mattybrad/omnistomp/enclosure/1590Balt.FCStd

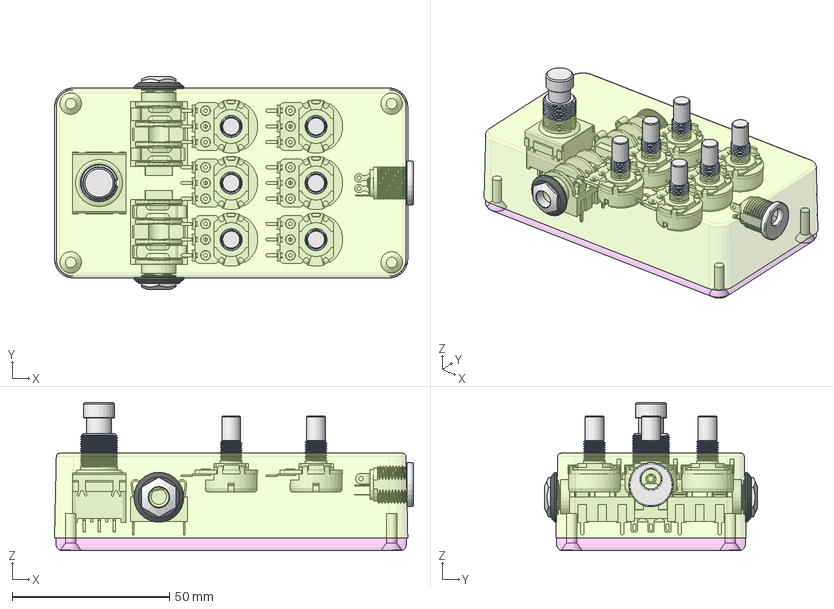
[picture p1: CAD file, 2025-01-20]
enclosure/1590Balt.FCStd
114.2 x 67.9 x 47.2 mm
1590B BOX
1590B-BS LID
SC530 (screw #6-32X 1_2' FH)
SC530 (screw #6-32X 1_2' FH)001
SC530 (screw #6-32X 1_2' FH)002
SC530 (screw #6-32X 1_2' FH)003
DC jack v1
SF17020F-0302-21R-L v2
NMJ4HCD2 v9
NMJ4HCD2 v010
PCB
header
header001
RV16AF-20 v3
RV16AF-20 v004
RV16AF-20 v005
RV16AF-20 v006
RV16AF-20 v007
RV16AF-20 v008
NMJ nut washer v1
NMJ nut v1
NMJ nut washer v002
NMJ nut v002
