mattybrad/omnistomp/enclosure/1590Btopjacks.FCStd

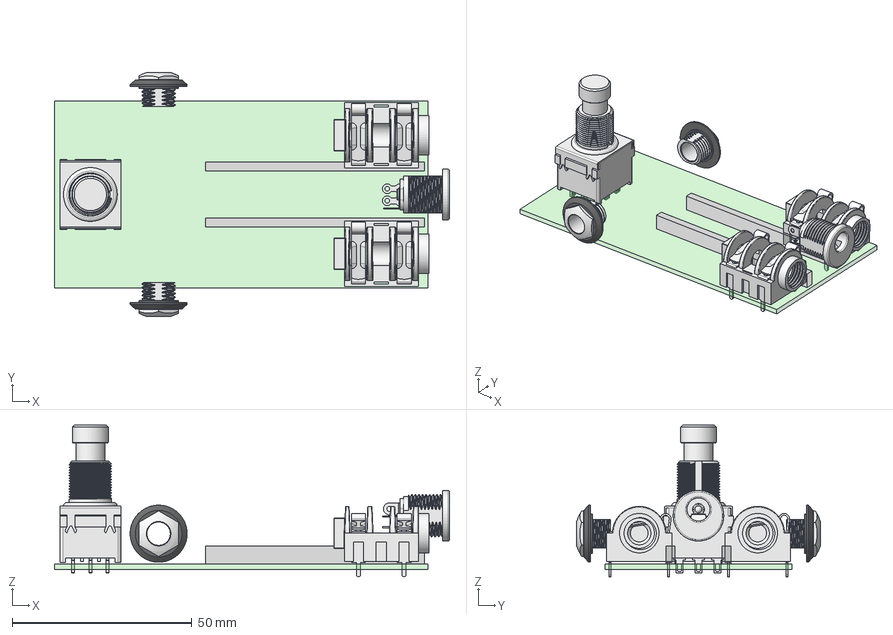
[picture p2: CAD file, 2025-01-20]
enclosure/1590Btopjacks.FCStd
110.0 x 67.9 x 42.2 mm
DC jack v1
SF17020F-0302-21R-L v2
NMJ4HCD2 v9
NMJ4HCD2 v010
PCB
header
header001
NMJ nut washer v1
NMJ nut v1
NMJ nut washer v002
NMJ nut v002
