mattybrad/omnistomp/enclosure/1590B.FCStd

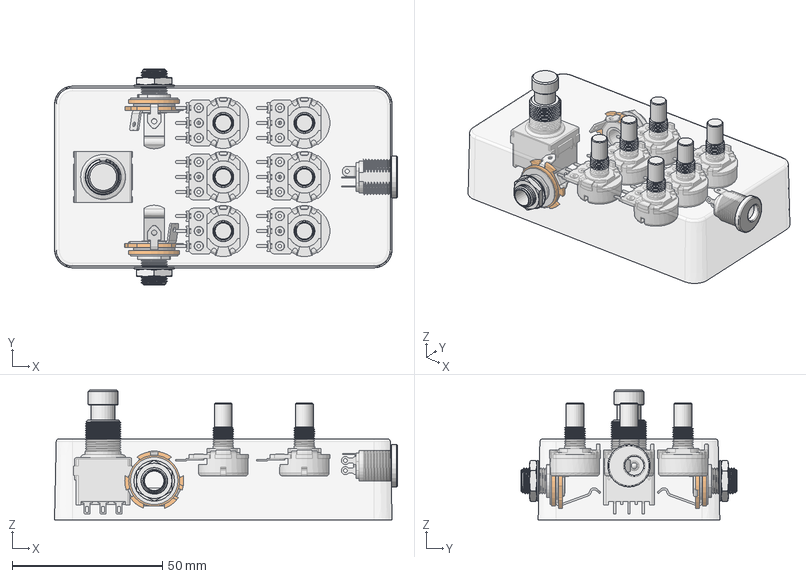
[picture p3: CAD file, 2025-01-17]
enclosure/1590B.FCStd
114.2 x 71.9 x 43.2 mm
1590B BOX
DC jack v1
SF17020F-0302-21R-L v2
PCB
Teensy 4.1
Washer005
Sleeve001
Common_contact001
Washer003
Output_contact001
Washer004
Wacher005
Thread001
Washer006
Washer007
Sleeve002
Common_contact002
Washer009
Output_contact002
Washer008
Wacher006
Thread002
Washer010
header
header001
RV16AF-20 v3
RV16AF-20 v004
RV16AF-20 v005
RV16AF-20 v006
RV16AF-20 v007
RV16AF-20 v008
