mattybrad/omnistomp/pcb/stomp_01/stomp_01.kicad_pcb

## KiCad design pcb/stomp_01/stomp_01.kicad_pcb (2025-05-21)

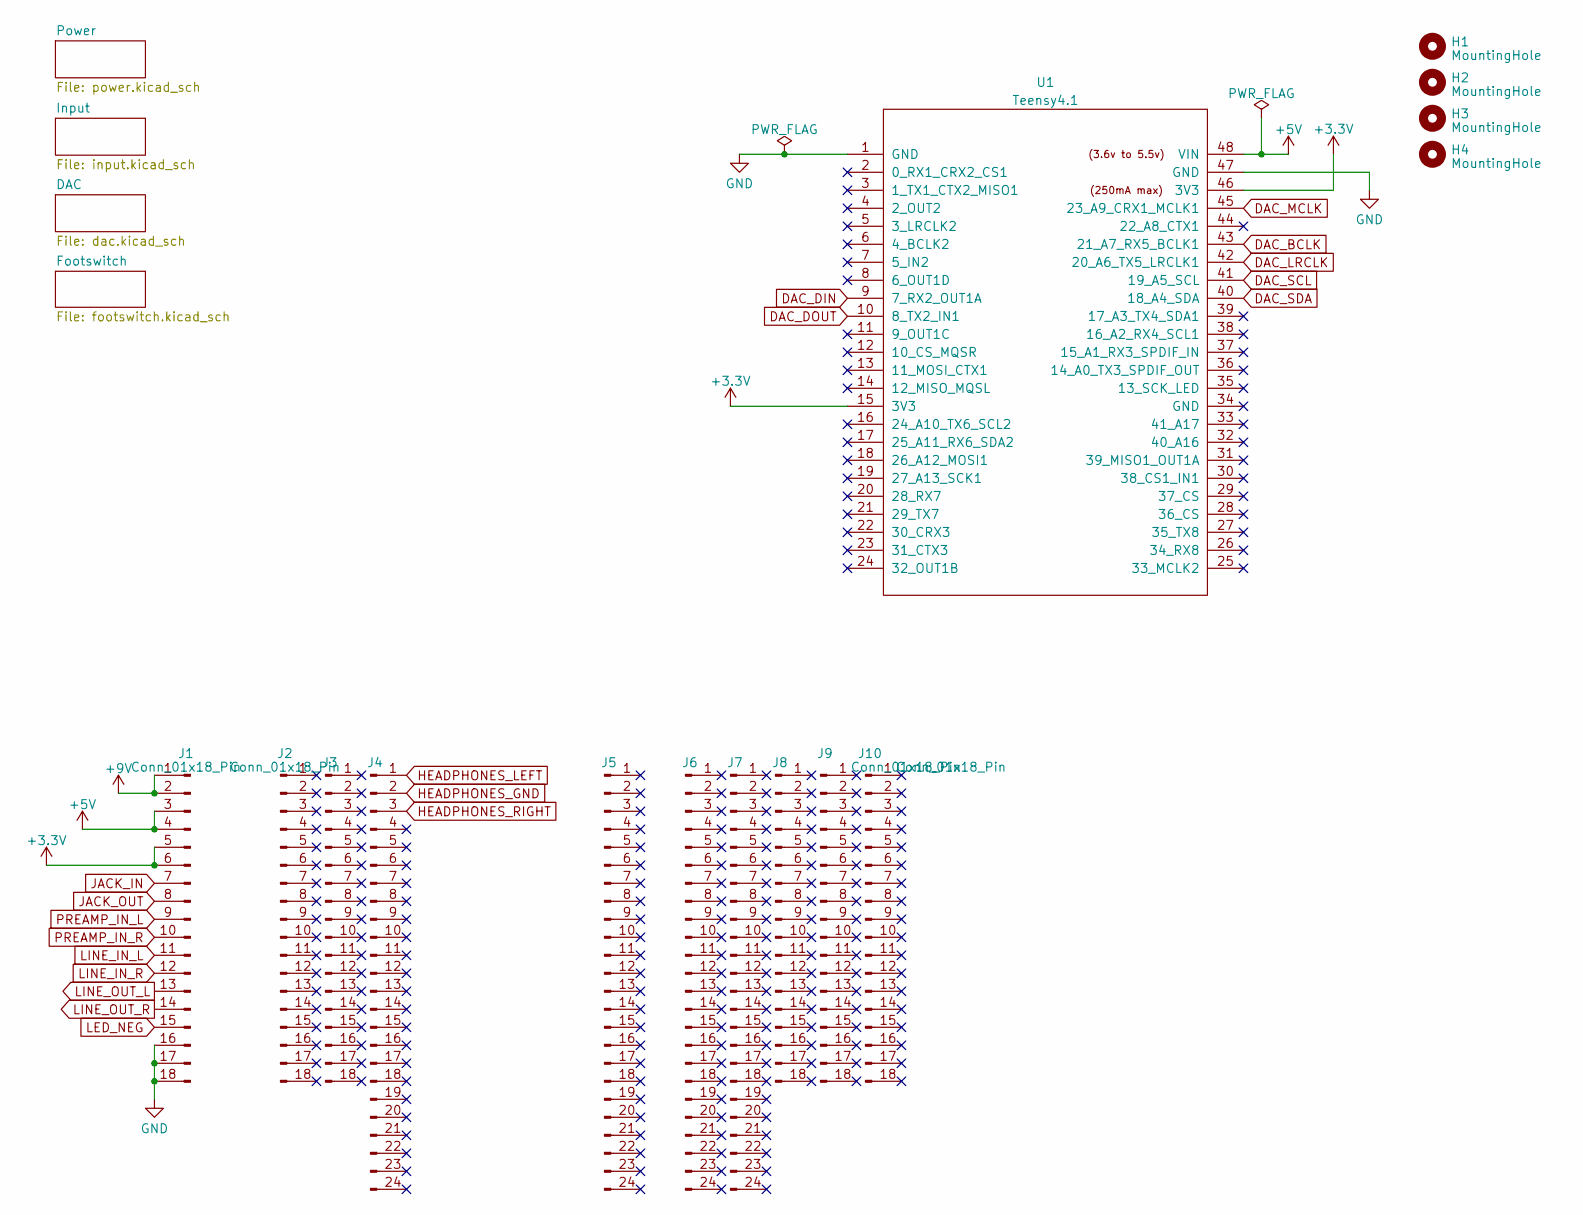
[picture p4: schematic stomp_01.kicad_sch]

Parts:
H1, H2, H3, H4: MountingHole; MountingHole_3.2mm_M3
J1, J2, J3, J8, J9, J10: Conn_01x18_Pin; PinHeader_1x18_P2.54mm_Vertical_perf
J4, J5, J6, J7: Conn_01x18_Pin; PinHeader_1x24_P2.54mm_Vertical_perf
U1: Teensy4.1; Teensy41_stomp

Connections:
+3.3V: J1.5, J1.6, U1.15 (3V3), U1.46 (3V3); also elsewhere on the board
+5V: J1.3, J1.4, U1.48 (VIN); also elsewhere on the board
+9V: J1.1, J1.2; also elsewhere on the board
DAC_BCLK: U1.43 (21_A7_RX5_BCLK1); also elsewhere on the board
DAC_DIN: U1.9 (7_RX2_OUT1A); also elsewhere on the board
DAC_DOUT: U1.10 (8_TX2_IN1); also elsewhere on the board
DAC_LRCLK: U1.42 (20_A6_TX5_LRCLK1); also elsewhere on the board
DAC_MCLK: U1.45 (23_A9_CRX1_MCLK1); also elsewhere on the board
DAC_SCL: U1.41 (19_A5_SCL); also elsewhere on the board
DAC_SDA: U1.40 (18_A4_SDA); also elsewhere on the board
GND: J1.16, J1.17, J1.18, U1.1 (GND), U1.47 (GND); also elsewhere on the board
HEADPHONES_GND: J4.2; also elsewhere on the board
HEADPHONES_LEFT: J4.1; also elsewhere on the board
HEADPHONES_RIGHT: J4.3; also elsewhere on the board
JACK_IN: J1.7; also elsewhere on the board
JACK_OUT: J1.8; also elsewhere on the board
LED_NEG: J1.15; also elsewhere on the board
LINE_IN_L: J1.11; also elsewhere on the board
LINE_IN_R: J1.12; also elsewhere on the board
LINE_OUT_L: J1.13; also elsewhere on the board
LINE_OUT_R: J1.14; also elsewhere on the board
PREAMP_IN_L: J1.9; also elsewhere on the board
PREAMP_IN_R: J1.10; also elsewhere on the board

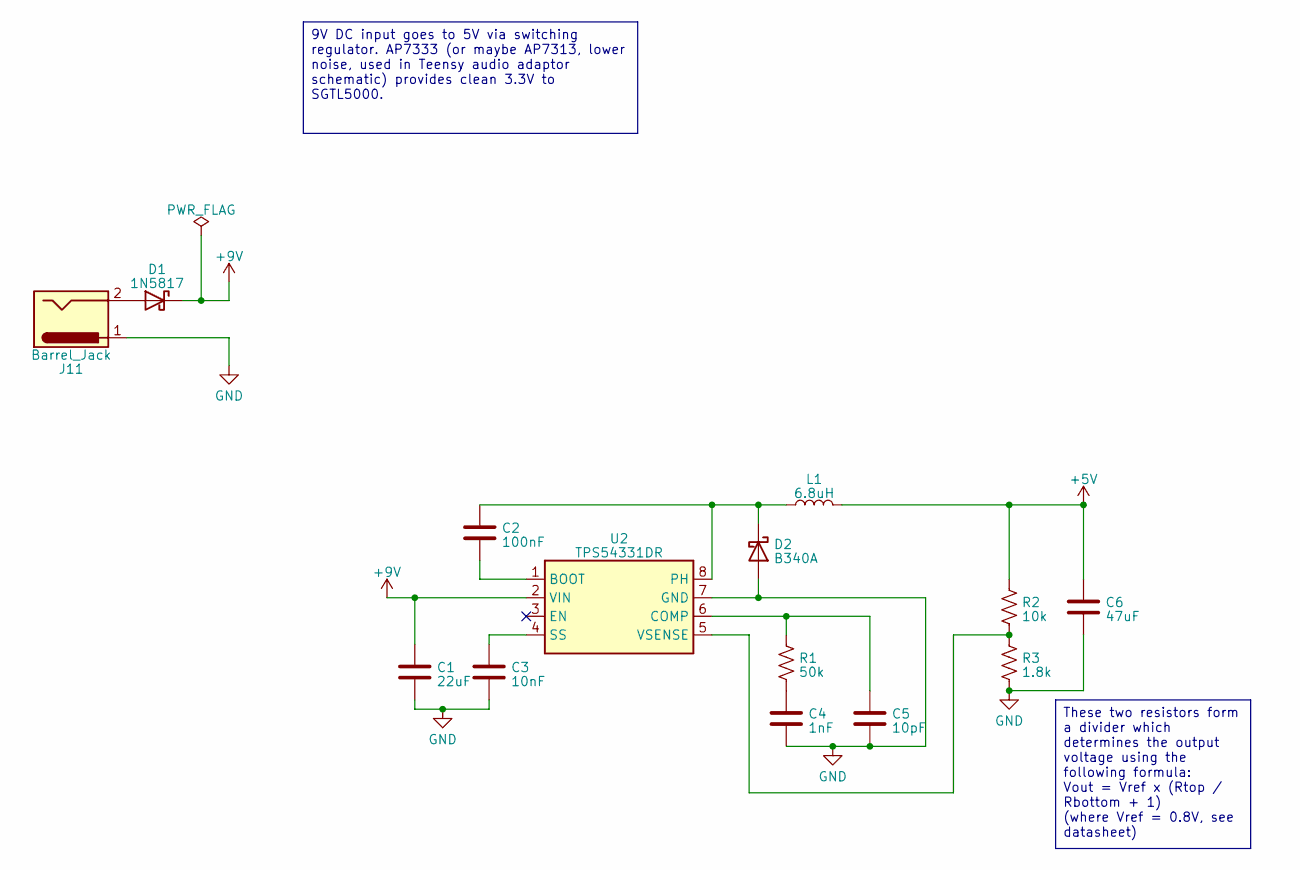
[picture p5: schematic power.kicad_sch]

Parts:
C1: 22uF; C_0805_2012Metric
C2: 100nF; C_0603_1608Metric
C3: 10nF; C_0603_1608Metric
C4: 1nF; C_0603_1608Metric
C5: 10pF; C_0603_1608Metric
C6: 47uF; C_1210_3225Metric
D1: 1N5817; D_DO-41_SOD81_P10.16mm_Horizontal
D2: B340A; D_SMA
J11: Barrel_Jack; SolderWire-1sqmm_1x02_P5.4mm_D1.4mm_OD2.7mm
L1: 6.8uH; L_Sunlord_SWPA6045S
R1: 50k; R_0603_1608Metric
R2: 10k; R_0603_1608Metric
R3: 1.8k; R_0603_1608Metric
U2: TPS54331DR; SOIC-8_3.9x4.9mm_P1.27mm

Connections:
+5V: C6.1, L1.2, R2.1; also elsewhere on the board
+9V: C1.1, D1.1 (K), U2.2 (VIN); also elsewhere on the board
GND: C1.2, C3.2, C4.2, C5.2, C6.2, D2.2 (A), J11.1, R3.2, U2.7 (GND); also elsewhere on the board
unnamed: C4.1, R1.2
unnamed: D1.2 (A), J11.2
unnamed: C2.1, D2.1 (K), L1.1, U2.8 (PH)
unnamed: C2.2, U2.1 (BOOT)
unnamed: C5.1, R1.1, U2.6 (COMP)
unnamed: C3.1, U2.4 (SS)
unnamed: R2.2, R3.1, U2.5 (VSENSE)

Notes on the sheet:
9V DC input goes to 5V via switching regulator. AP7333 (or maybe AP7313, lower noise, used in Teensy audio adaptor schematic) provides clean 3.3V to SGTL5000.
These two resistors form a divider which determines the output voltage using the following formula: Vout = Vref x (Rtop / Rbottom + 1) (where Vref = 0.8V, see datasheet)

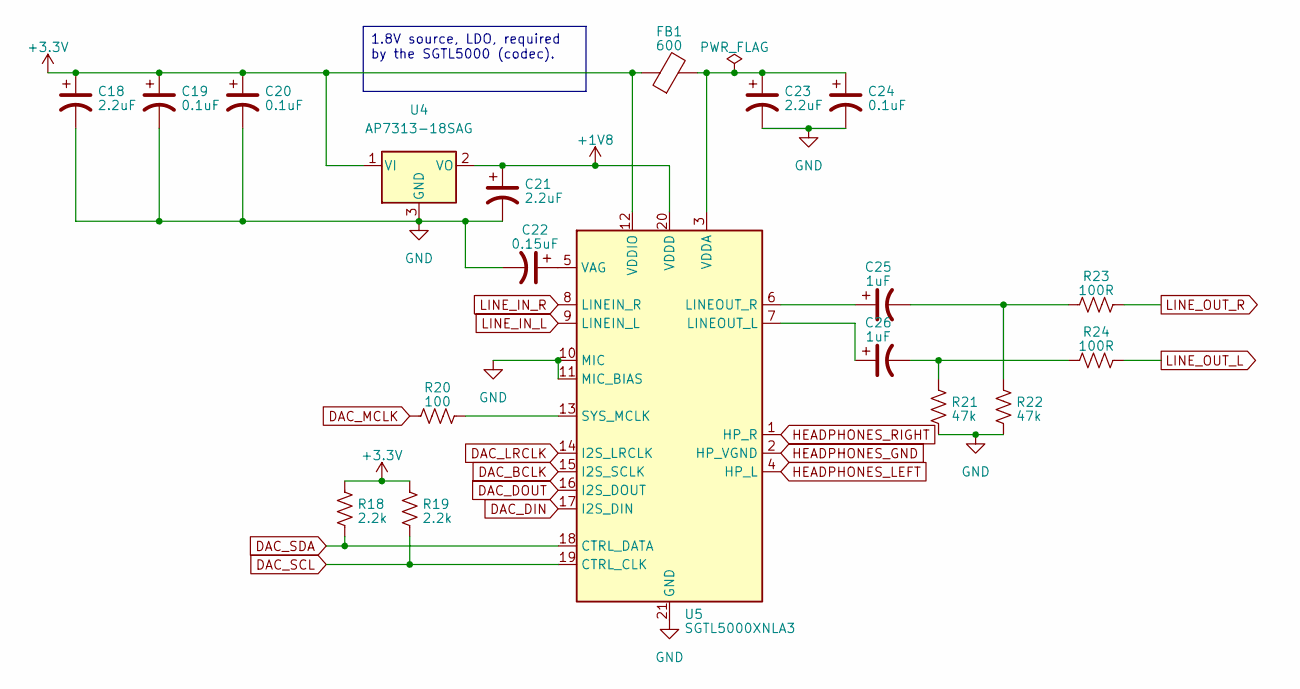
[picture p6: schematic dac.kicad_sch]

Parts:
C18, C21, C23: 2.2uF; C_0603_1608Metric
C19, C20, C24: 0.1uF; C_0603_1608Metric
C22: 0.15uF; C_0603_1608Metric
C25, C26: 1uF; C_0603_1608Metric
FB1: 600; L_0603_1608Metric
R18, R19: 2.2k; R_0603_1608Metric
R20: 100; R_0603_1608Metric
R21, R22: 47k; R_0603_1608Metric
R23, R24: 100R; R_0603_1608Metric
U4: AP7313-18SAG; SOT-23
U5: SGTL5000XNLA3; QFN-20-1EP_3x3mm_P0.4mm_EP1.65x1.65mm

Connections:
+1V8: C21.1, U4.2 (VO), U5.20 (VDDD)
+3.3V: C18.1, C19.1, C20.1, FB1.1, R18.2, R19.2, U4.1 (VI), U5.12 (VDDIO); also elsewhere on the board
DAC_BCLK: U5.15 (I2S_SCLK); also elsewhere on the board
DAC_DIN: U5.17 (I2S_DIN); also elsewhere on the board
DAC_DOUT: U5.16 (I2S_DOUT); also elsewhere on the board
DAC_LRCLK: U5.14 (I2S_LRCLK); also elsewhere on the board
DAC_MCLK: R20.2; also elsewhere on the board
DAC_SCL: R19.1, U5.19 (CTRL_CLK); also elsewhere on the board
DAC_SDA: R18.1, U5.18 (CTRL_DATA); also elsewhere on the board
GND: C18.2, C19.2, C20.2, C21.2, C22.2, C23.2, C24.2, R21.1, R22.1, U4.3 (GND), U5.10 (MIC), U5.11 (MIC_BIAS), U5.21 (GND); also elsewhere on the board
HEADPHONES_GND: U5.2 (HP_VGND); also elsewhere on the board
HEADPHONES_LEFT: U5.4 (HP_L); also elsewhere on the board
HEADPHONES_RIGHT: U5.1 (HP_R); also elsewhere on the board
LINE_IN_L: U5.9 (LINEIN_L); also elsewhere on the board
LINE_IN_R: U5.8 (LINEIN_R); also elsewhere on the board
LINE_OUT_L: R24.1; also elsewhere on the board
LINE_OUT_R: R23.1; also elsewhere on the board
unnamed: C25.2, R22.2, R23.2
unnamed: C26.2, R21.2, R24.2
unnamed: C26.1, U5.7 (LINEOUT_L)
unnamed: C25.1, U5.6 (LINEOUT_R)
unnamed: R20.1, U5.13 (SYS_MCLK)
unnamed: C22.1, U5.5 (VAG)
unnamed: C23.1, C24.1, FB1.2, U5.3 (VDDA)

Notes on the sheet:
1.8V source, LDO, required by the SGTL5000 (codec).

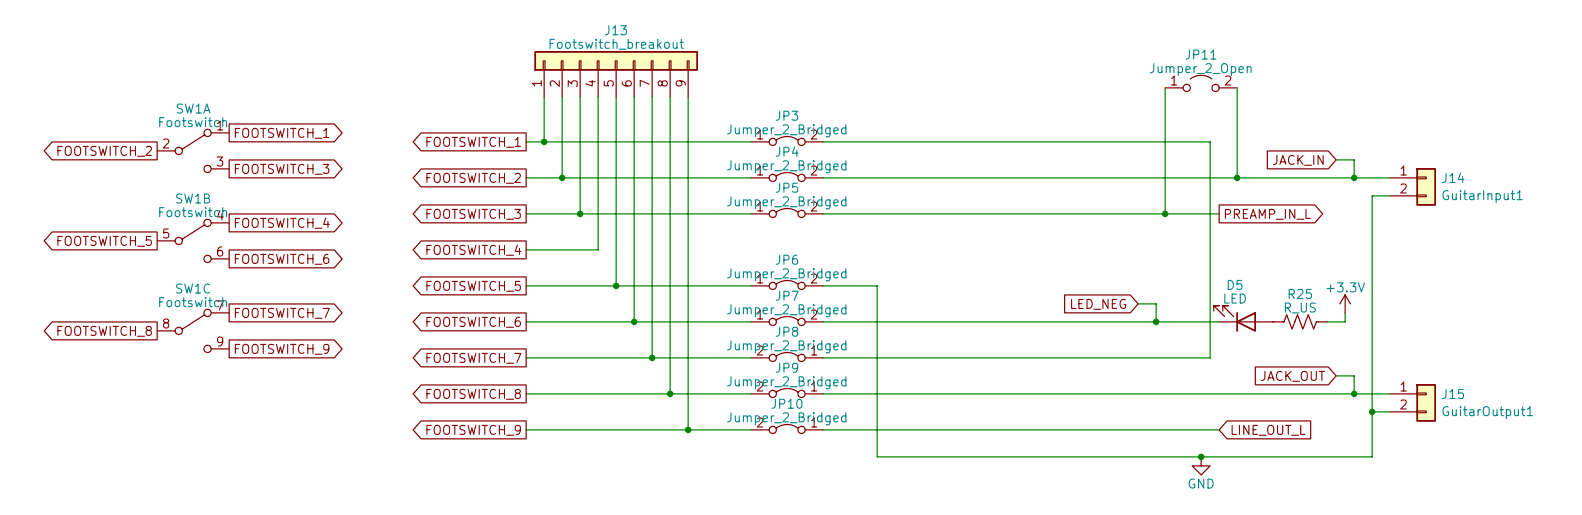
[picture p7: schematic footswitch.kicad_sch]

Parts:
D5: LED; LED_D5.0mm
J13: Footswitch_breakout; PinHeader_3x03_P2.54mm_Vertical_footswitch_breakout
J14: GuitarInput1; SolderWire-1sqmm_1x02_P5.4mm_D1.4mm_OD2.7mm
J15: GuitarOutput1; SolderWire-1sqmm_1x02_P5.4mm_D1.4mm_OD2.7mm
JP3, JP4, JP5, JP6, JP7, JP8, JP9, JP10: Jumper_2_Bridged; SolderJumper-2_P1.3mm_Bridged2Bar_RoundedPad1.0x1.5mm
JP11: Jumper_2_Open; SolderJumper-2_P1.3mm_Open_RoundedPad1.0x1.5mm
R25: R_US; R_Axial_DIN0207_L6.3mm_D2.5mm_P7.62mm_Horizontal
SW1: Footswitch; Footswitch_3PDT

Connections:
+3.3V: R25.2; also elsewhere on the board
FOOTSWITCH_1: J13.1, JP3.1 (A), SW1.1 (A)
FOOTSWITCH_2: J13.2, JP4.1 (A), SW1.2 (B)
FOOTSWITCH_3: J13.3, JP5.1 (A), SW1.3 (C)
FOOTSWITCH_4: J13.4, SW1.4 (A)
FOOTSWITCH_5: J13.5, JP6.1 (A), SW1.5 (B)
FOOTSWITCH_6: J13.6, JP7.1 (A), SW1.6 (C)
FOOTSWITCH_7: J13.7, JP8.2 (B), SW1.7 (A)
FOOTSWITCH_8: J13.8, JP9.2 (B), SW1.8 (B)
FOOTSWITCH_9: J13.9, JP10.2 (B), SW1.9 (C)
GND: J14.2, J15.2, JP6.2 (B); also elsewhere on the board
JACK_IN: J14.1, JP4.2 (B), JP11.2 (B); also elsewhere on the board
JACK_OUT: J15.1, JP9.1 (A); also elsewhere on the board
LED_NEG: D5.1 (K), JP7.2 (B); also elsewhere on the board
LINE_OUT_L: JP10.1 (A); also elsewhere on the board
unnamed: D5.2 (A), R25.1
unnamed: JP3.2 (B), JP8.1 (A)
PREAMP_IN_L: JP5.2 (B), JP11.1 (A); also elsewhere on the board

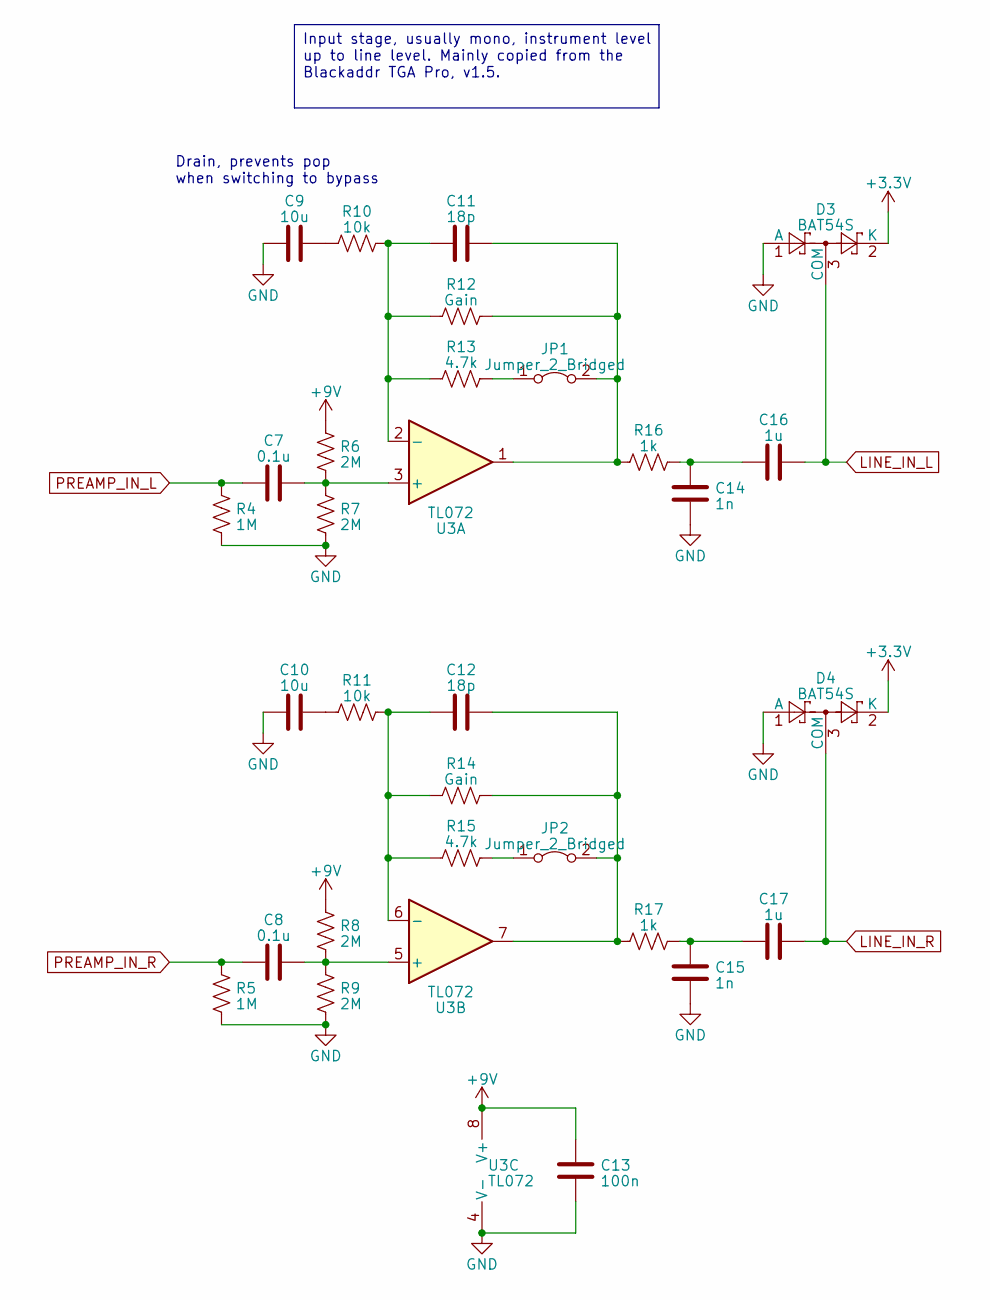
[picture p8: schematic input.kicad_sch]

Parts:
C7, C8: 0.1u; C_0603_1608Metric
C9, C10: 10u; C_0603_1608Metric
C11, C12: 18p; C_0603_1608Metric
C13: 100n; C_0603_1608Metric
C14, C15: 1n; C_0603_1608Metric
C16, C17: 1u; C_0603_1608Metric
D3, D4: BAT54S; SOT-23
JP1, JP2: Jumper_2_Bridged; SolderJumper-2_P1.3mm_Bridged2Bar_RoundedPad1.0x1.5mm
R4, R5: 1M; R_0603_1608Metric
R6, R7, R8, R9: 2M; R_0603_1608Metric
R10, R11: 10k; R_0603_1608Metric
R12, R14: Gain; R_Axial_DIN0207_L6.3mm_D2.5mm_P7.62mm_Horizontal
R13, R15: 4.7k; R_0603_1608Metric
R16, R17: 1k; R_0603_1608Metric
U3: TL072; SOIC-8_3.9x4.9mm_P1.27mm

Connections:
+3.3V: D3.2 (K), D4.2 (K); also elsewhere on the board
+9V: C13.2, R6.1, R8.1, U3.8 (V+); also elsewhere on the board
GND: C9.1, C10.1, C13.1, C14.2, C15.2, D3.1 (A), D4.1 (A), R4.2, R5.2, R7.2, R9.2, U3.4 (V-); also elsewhere on the board
LINE_IN_L: C16.1, D3.3 (COM); also elsewhere on the board
LINE_IN_R: C17.1, D4.3 (COM); also elsewhere on the board
unnamed: C9.2, R10.1
unnamed: C10.2, R11.1
unnamed: C14.1, C16.2, R16.2
unnamed: C15.1, C17.2, R17.2
unnamed: JP1.1 (A), R13.2
unnamed: C11.2, JP1.2 (B), R12.2, R16.1, U3.1
unnamed: JP2.1 (A), R15.2
unnamed: C12.2, JP2.2 (B), R14.2, R17.1, U3.7
unnamed: C7.2, R6.2, R7.1, U3.3 (+)
unnamed: C11.1, R10.2, R12.1, R13.1, U3.2 (-)
unnamed: C8.2, R8.2, R9.1, U3.5 (+)
unnamed: C12.1, R11.2, R14.1, R15.1, U3.6 (-)
PREAMP_IN_L: C7.1, R4.1; also elsewhere on the board
PREAMP_IN_R: C8.1, R5.1; also elsewhere on the board

Notes on the sheet:
Drain, prevents pop when switching to bypass
Input stage, usually mono, instrument level up to line level. Mainly copied from the Blackaddr TGA Pro, v1.5.

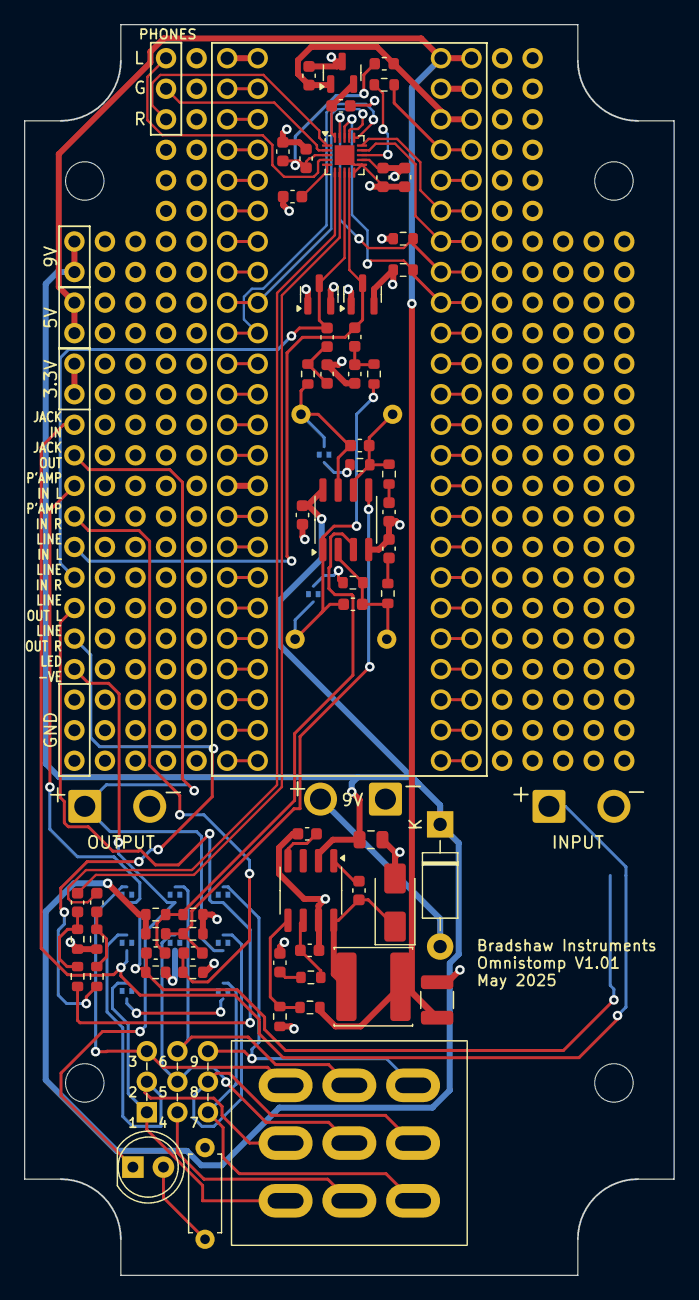
[picture p9: board stomp_01.kicad_pcb from above]

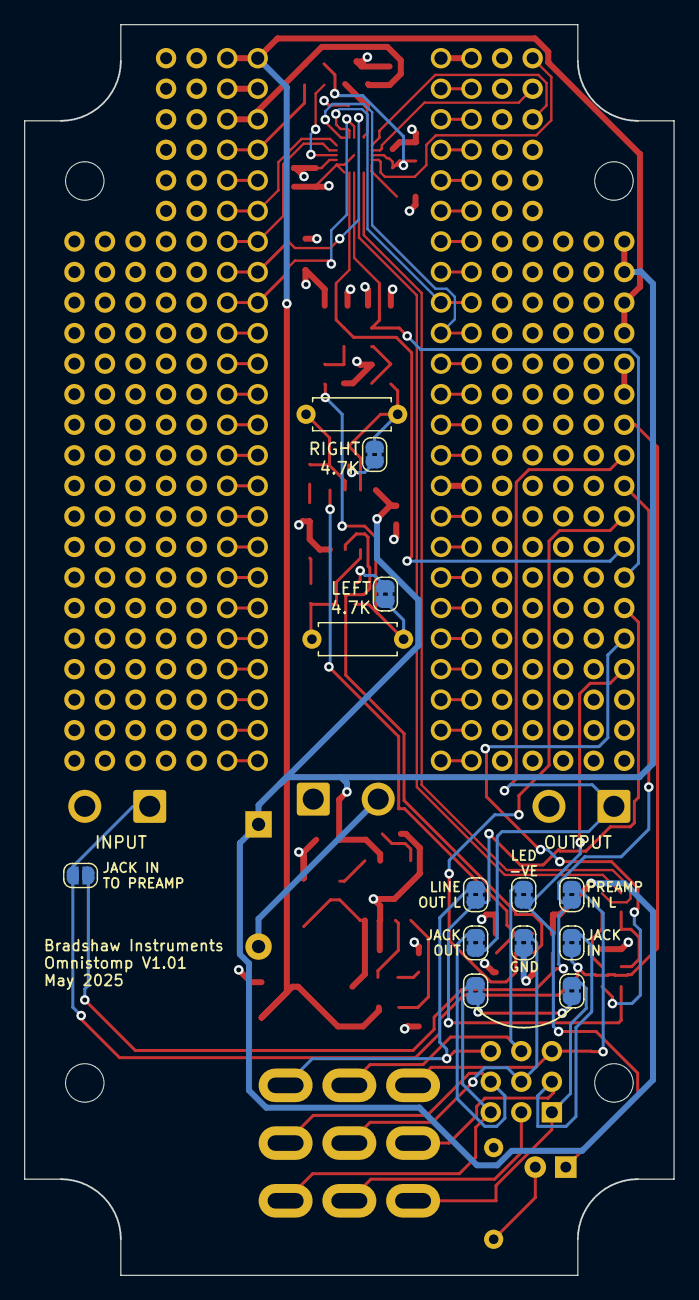
[picture p10: board stomp_01.kicad_pcb from below]

Board: 4 copper layers, 54.0 x 104.0 mm, 93 parts (13 on the bottom side), 61 nets.
