mattybrad/omnistomp/(commit log)

2023-09-06 early schematic stuff
    [dac.kicad_sch, input.kicad_sch, output.kicad_sch, power.kicad_sch, stomp_00.kicad_pcb, stomp_00.kicad_sch]
2025-01-13 came back to the project
    [power.kicad_sch, stomp_00.kicad_pcb, stomp_00.kicad_sch]
2025-01-13 more sheets
    [analoginput.kicad_sch, digitalinput.kicad_sch, digitaloutput.kicad_sch, input.kicad_sch, stomp_00.kicad_sch]
2025-01-13 adding all the components...
    [analoginput.kicad_sch, digitalinput.kicad_sch, digitaloutput.kicad_sch, input.kicad_sch, midi.kicad_sch, output.kicad_sch, stomp_00.kicad_sch]
2025-01-15 not much
    [stomp_00.kicad_sch]
2025-01-15 freecad stuff
    [1590B.FCStd]
2025-01-16 taking shape...
    [1590B.FCStd, analoginput.kicad_sch, dac.kicad_sch, digitalinput.kicad_sch, digitaloutput.kicad_sch, input.kicad_sch, midi.kicad_sch, output.kicad_sch]
2025-01-16 teensy footprint
    [1590B.FCStd, stomp_00.kicad_pcb, stomp_00.kicad_sch]
2025-01-16 seeing whether everything will fit...
    [dac.kicad_sch, input.kicad_sch, power.kicad_sch, stomp_00.kicad_pcb, stomp_00.kicad_sch]
2025-01-16 input stage schematic
    [1590B.FCStd, dac.kicad_sch, input.kicad_sch, output.kicad_sch, stomp_00.kicad_pcb, stomp_00.kicad_sch]
2025-01-16 more input stage faffing
    [dac.kicad_sch, input.kicad_sch, stomp_00.kicad_sch]
2025-01-17 better layout in enclosure
    [1590B.FCStd, 1590Balt.FCStd, dac.kicad_sch, input.kicad_sch, stomp_00.kicad_pcb]
2025-01-18 good progress with physical layout
    [stomp_00.kicad_pcb, stomp_00.kicad_sch]
2025-01-19 footswitch routing
    [dac.kicad_sch, input.kicad_sch, stomp_00.kicad_pcb, stomp_00.kicad_sch]
2025-01-20 tweaking layout, issue with usb socket placement
    [1590Balt.FCStd, 1590Btopjacks.FCStd, footswitch.kicad_sch, power.kicad_sch, stomp_00.kicad_pcb]
2025-01-21 9v power stuff
    [power.kicad_sch, stomp_00.kicad_pcb]
2025-01-21 changed voltage regulator
    [input.kicad_sch, power.kicad_sch, stomp_00.kicad_pcb]
2025-01-21 adding perfboard section
    [stomp_00.kicad_pcb, stomp_00.kicad_sch]
2025-01-22 tidying up footprints, layout, etc
    [footswitch.kicad_sch, stomp_00.kicad_pcb, stomp_00.kicad_sch]
2025-01-22 tidying up dac connections
    [dac.kicad_sch, footswitch.kicad_sch, input.kicad_sch, stomp_00.kicad_pcb]
2025-01-24 layout getting closer
    [dac.kicad_sch, footswitch.kicad_sch, input.kicad_sch, stomp_00.kicad_pcb, stomp_00.kicad_sch]
2025-01-28 fixing ERC stuff, importing PCB into freecad
    [dac.kicad_sch, footswitch.kicad_sch, input.kicad_sch, power.kicad_sch, stomp_00.kicad_pcb, stomp_00.kicad_sch]
2025-01-28 save before routing
    [stomp_00.kicad_pcb]
2025-01-28 <50 unrouted...
    [stomp_00.kicad_pcb]
2025-01-29 7 unrouted...
    [stomp_00.kicad_pcb]
2025-01-29 passed ERC!
    [dac.kicad_sch, footswitch.kicad_sch, stomp_00.kicad_pcb]
2025-02-17 pcb done
    [power.kicad_sch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]
2025-05-20 where does everything go
    [analoginput.kicad_sch, dac.kicad_sch, digitalinput.kicad_sch, digitaloutput.kicad_sch, footswitch.kicad_sch, input.kicad_sch, midi.kicad_sch, output.kicad_sch]
2025-05-20 more tweaks
    [stomp_01.kicad_pcb]
2025-05-20 looking nice
    [dac.kicad_sch, footswitch.kicad_sch, input.kicad_sch, power.kicad_sch, stomp_01.kicad_pcb, stomp_01.kicad_sch]
2025-05-21 pre routing
    [dac.kicad_sch, power.kicad_sch, stomp_01.kicad_pcb, stomp_01.kicad_sch]
2025-05-21 100 unrouted
    [stomp_01.kicad_pcb]
2025-05-21 53 unrouted
    [stomp_01.kicad_pcb]
2025-05-21 zero unrouted
    [stomp_01.kicad_pcb]
2025-05-21 pcb v1.01 done
    [stomp_01-CuBottom.gbr, stomp_01-CuIn1.gbr, stomp_01-CuIn2.gbr, stomp_01-CuTop.gbr, stomp_01-EdgeCuts.gbr, stomp_01-MaskBottom.gbr, stomp_01-MaskTop.gbr, stomp_01-NPTH.drl]
